Yuvraj2412/SKYFORCE/Final_Hackathon_PPt.docx

Anti-Drone Interceptor

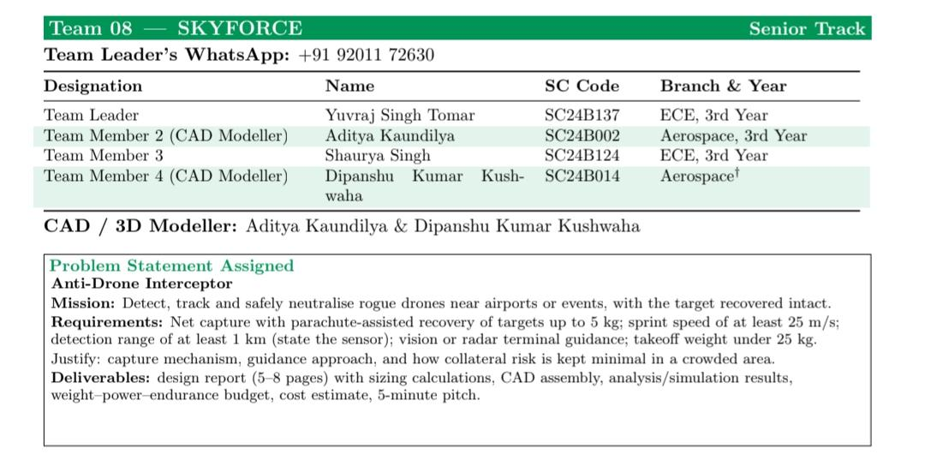
[picture p1: figure]

by Team Skyforce

The brief is to detect, track and safely neutralise a rogue drone near an airport or event, with the target recovered intact. The design must justify the capture mechanism, the guidance approach and how collateral risk is kept minimal. The requirements the design and simulation respect are:

• net capture with parachute-assisted recovery of targets up to 5 kg;

• sprint speed of at least 25 m/s;

• detection range of at least 1 km using a stated sensor (ground radar);

• vision or radar terminal guidance;

• takeoff weight under 25 kg.

Deliverables are the design report with sizing calculations, CAD, analysis/simulation results, a budget and a cost estimate.

Inspiration and Literature Review-:

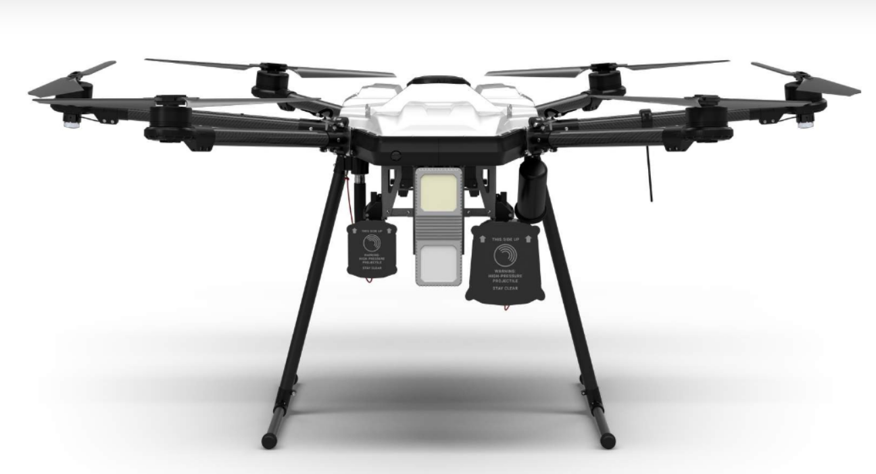
[picture p2: figure]
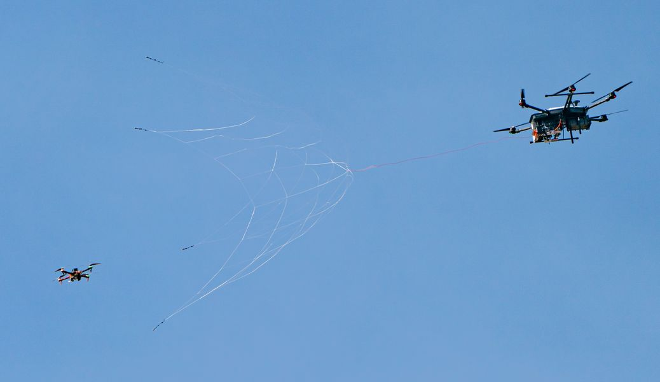
[picture p3: figure]

DroneHunter® F700

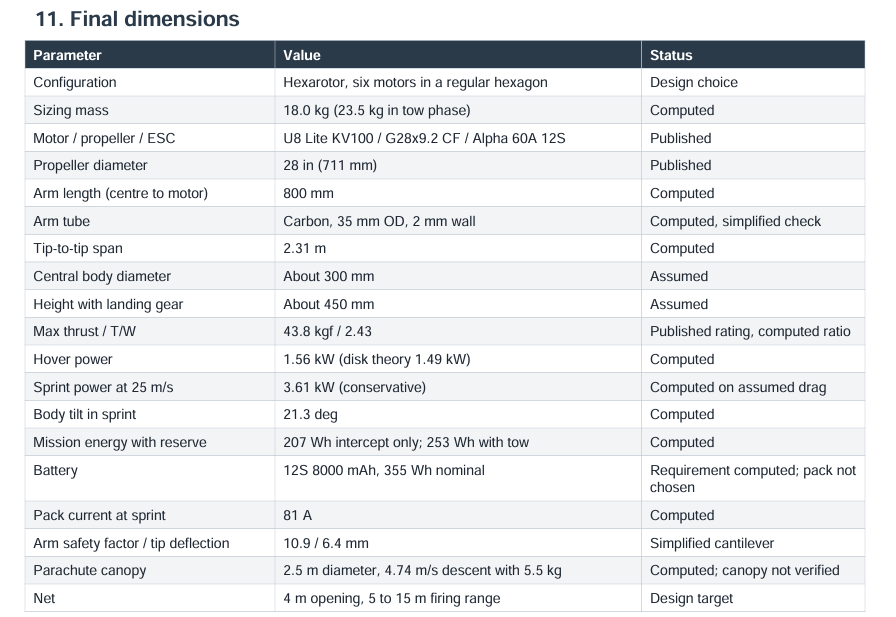
[picture p4: figure]

Used by USA Military for drone interception

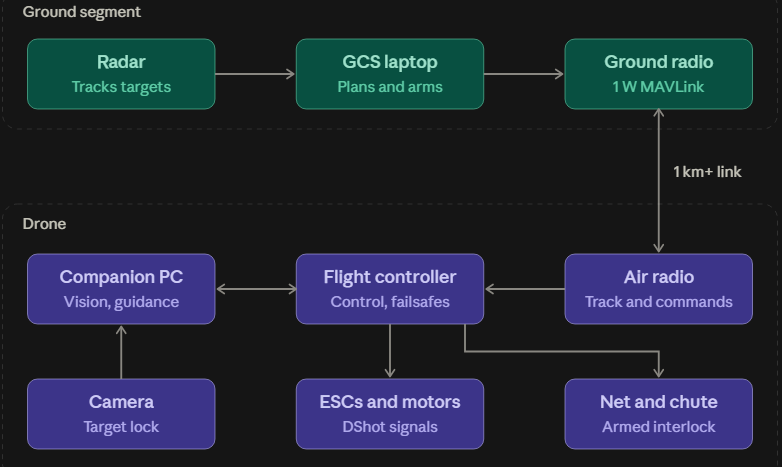
[picture p5: figure]
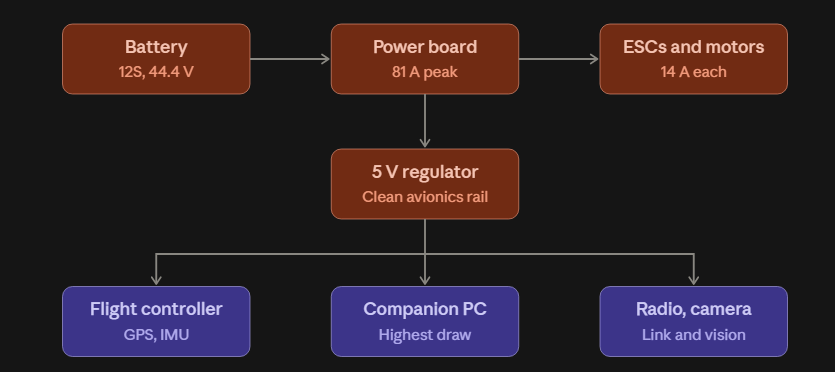
[picture p6: figure]
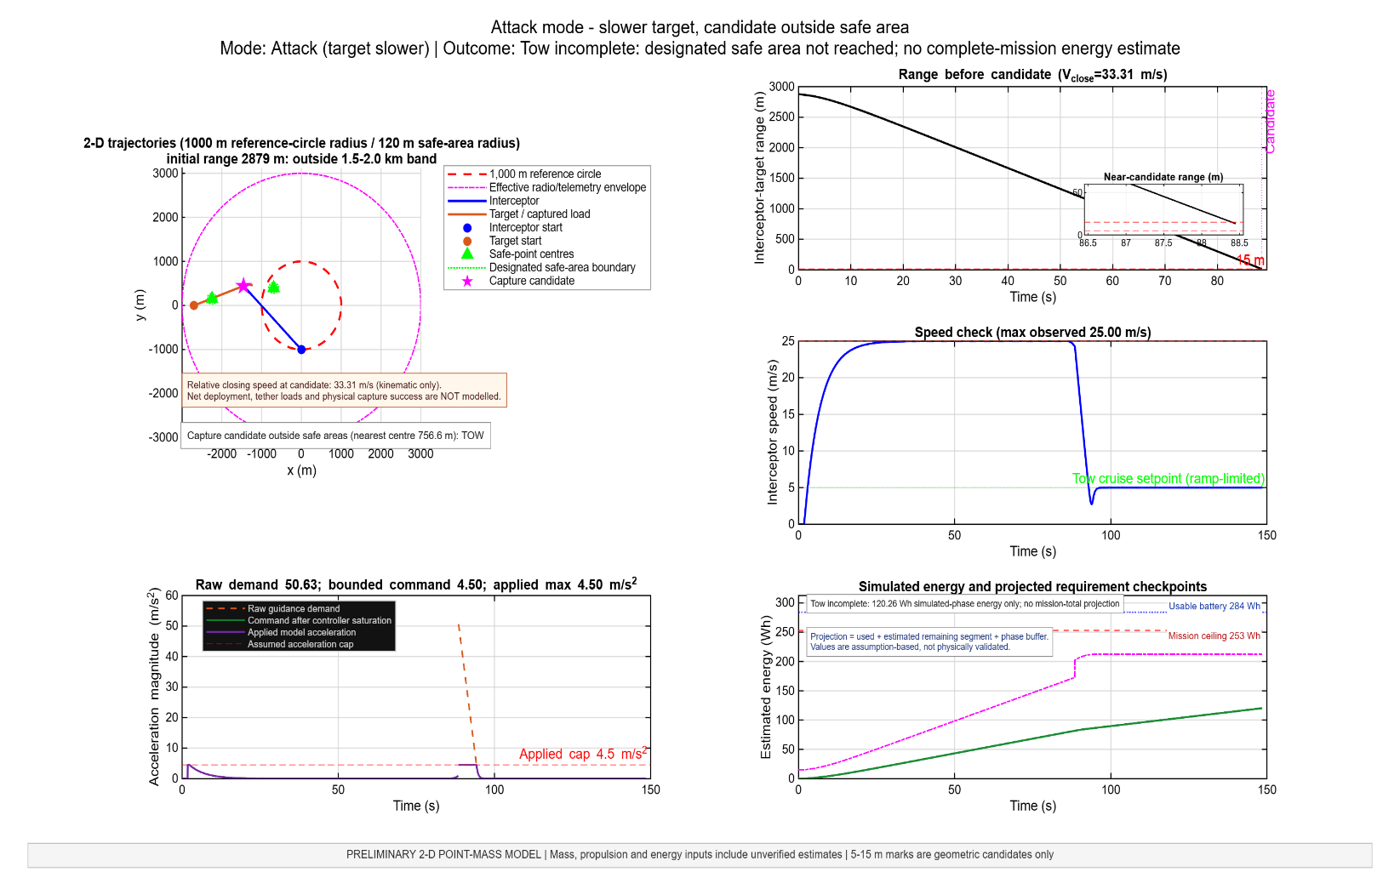
[picture p7: figure]
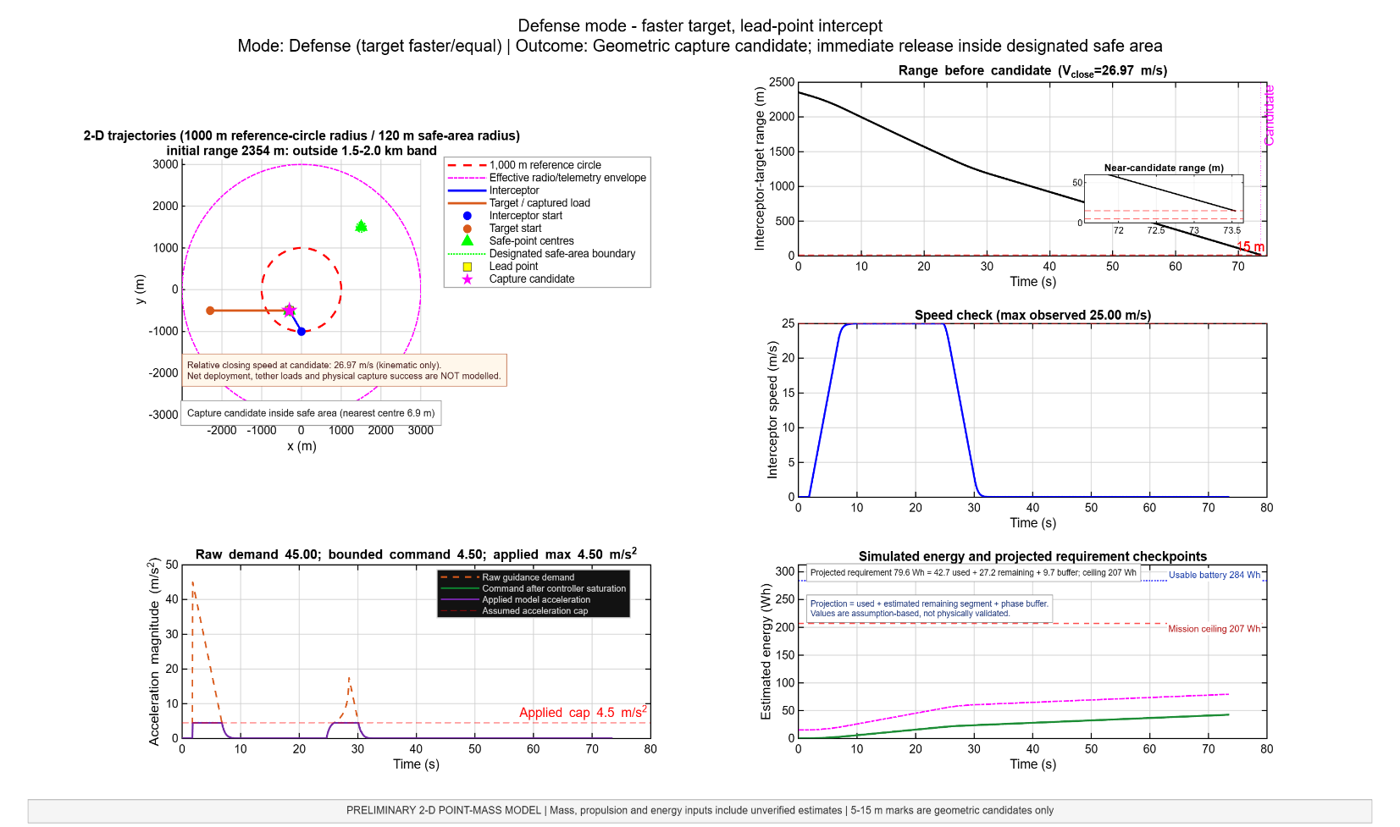
[picture p8: figure]

MATLAB SIMULATIONS-:

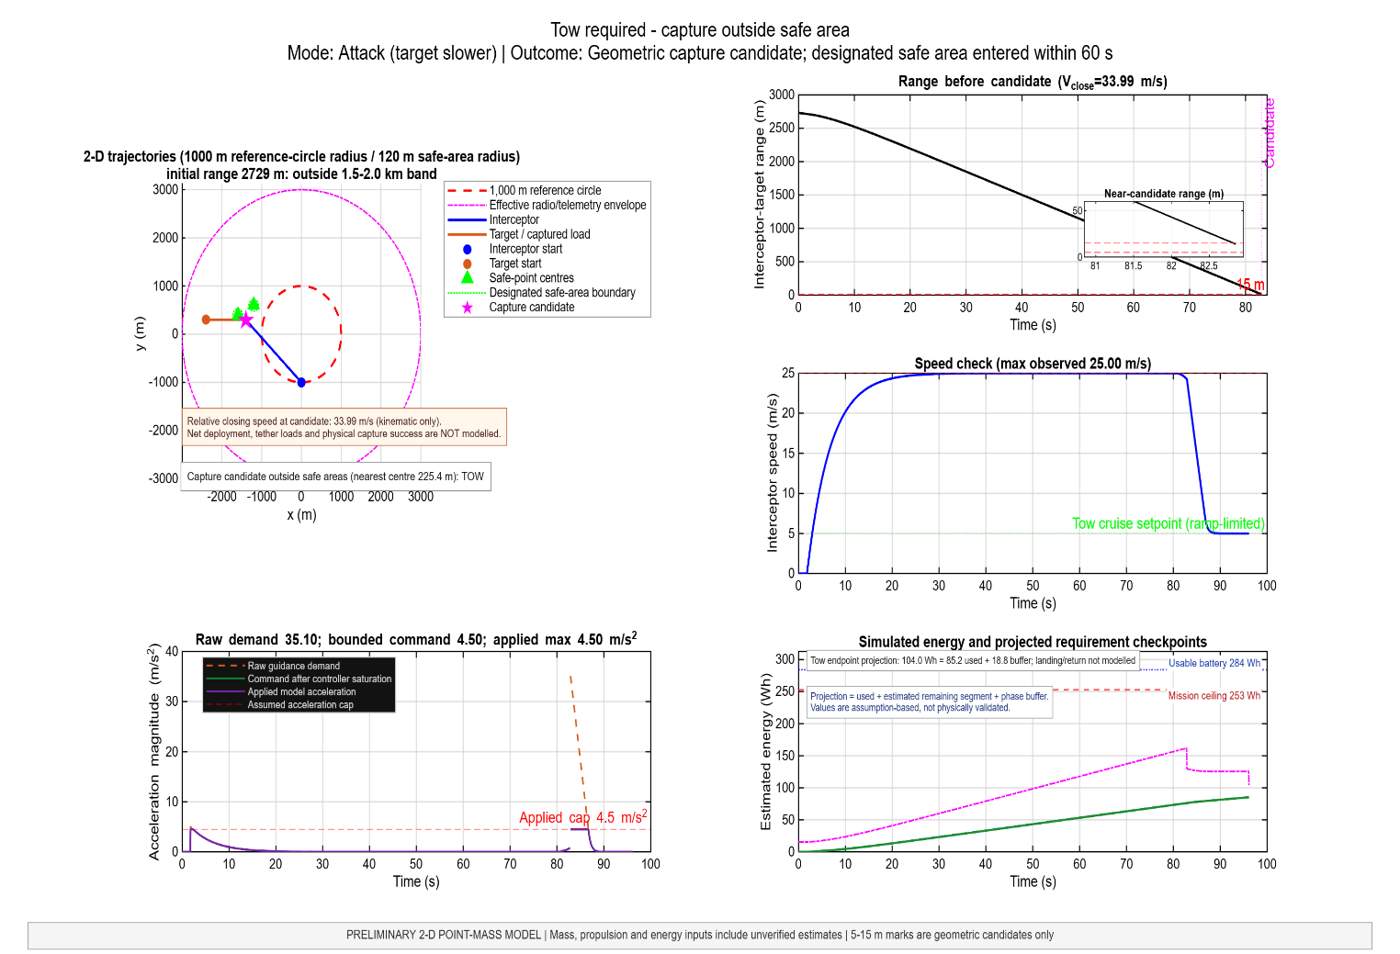
[picture p9: figure]
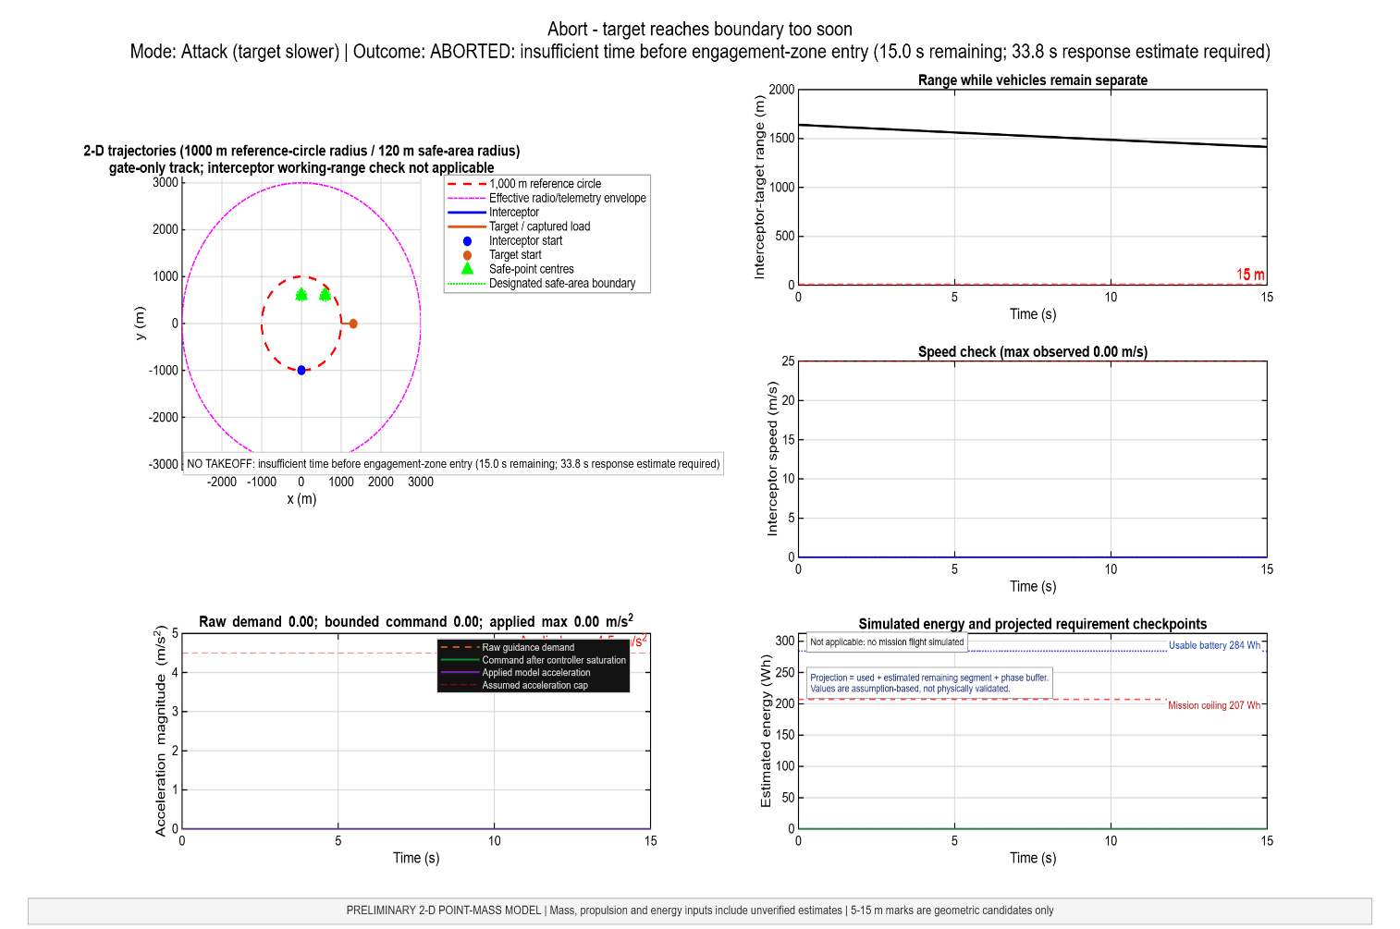
[picture p10: figure]
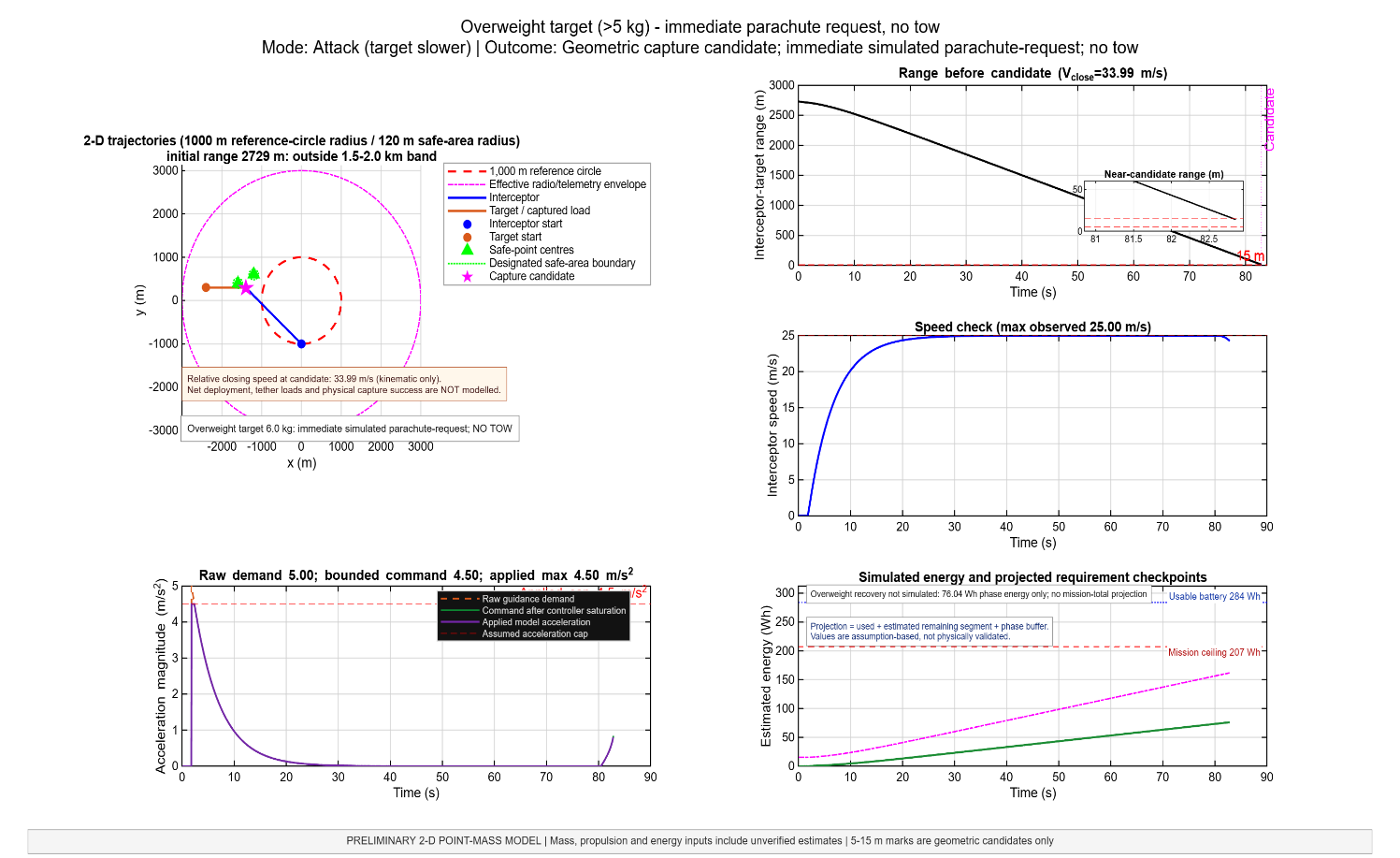
[picture p11: figure]
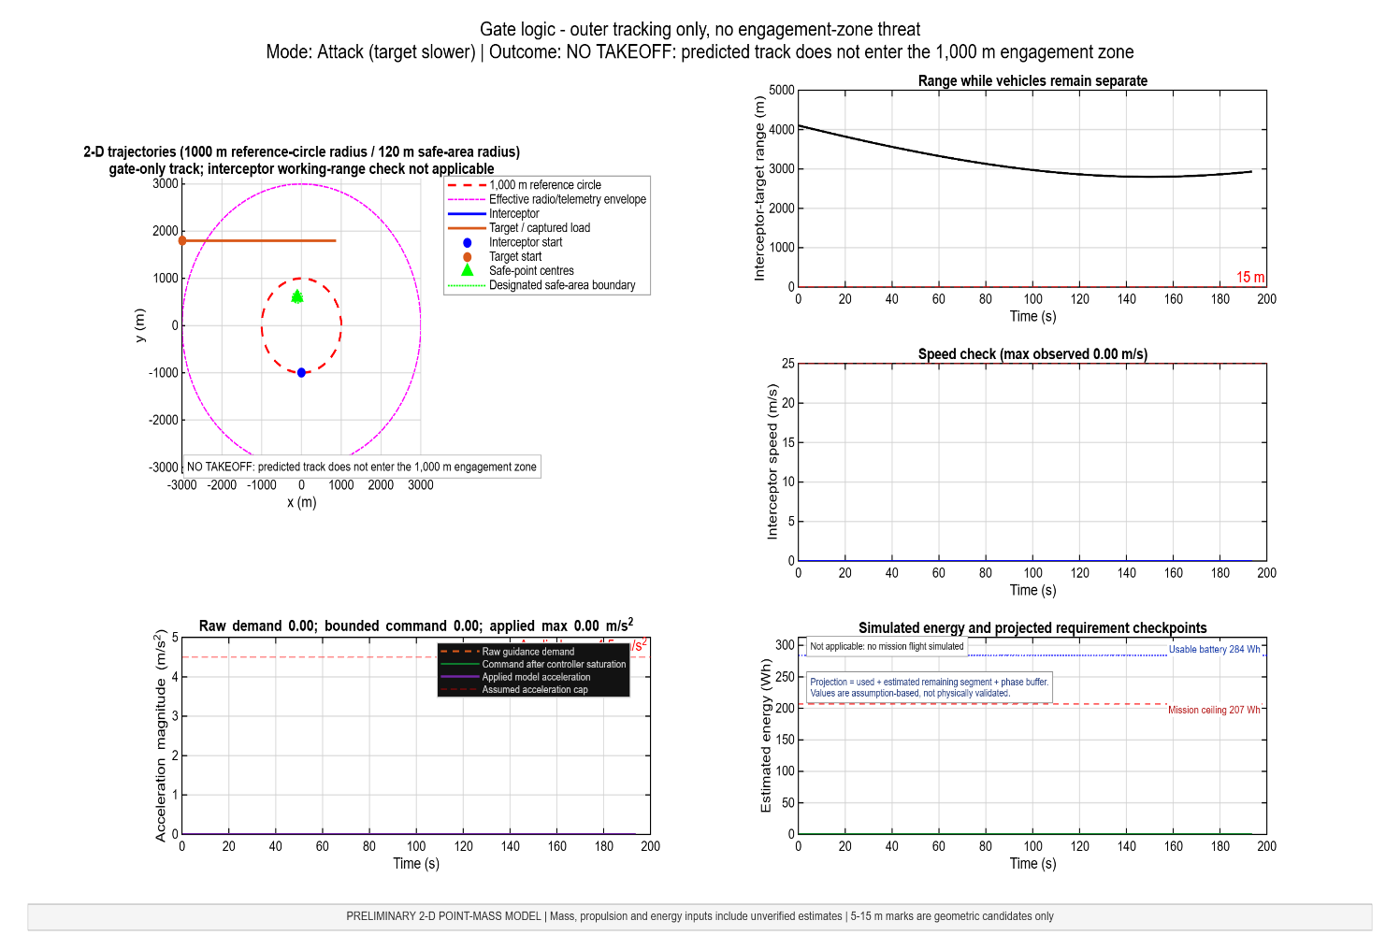
[picture p12: figure]
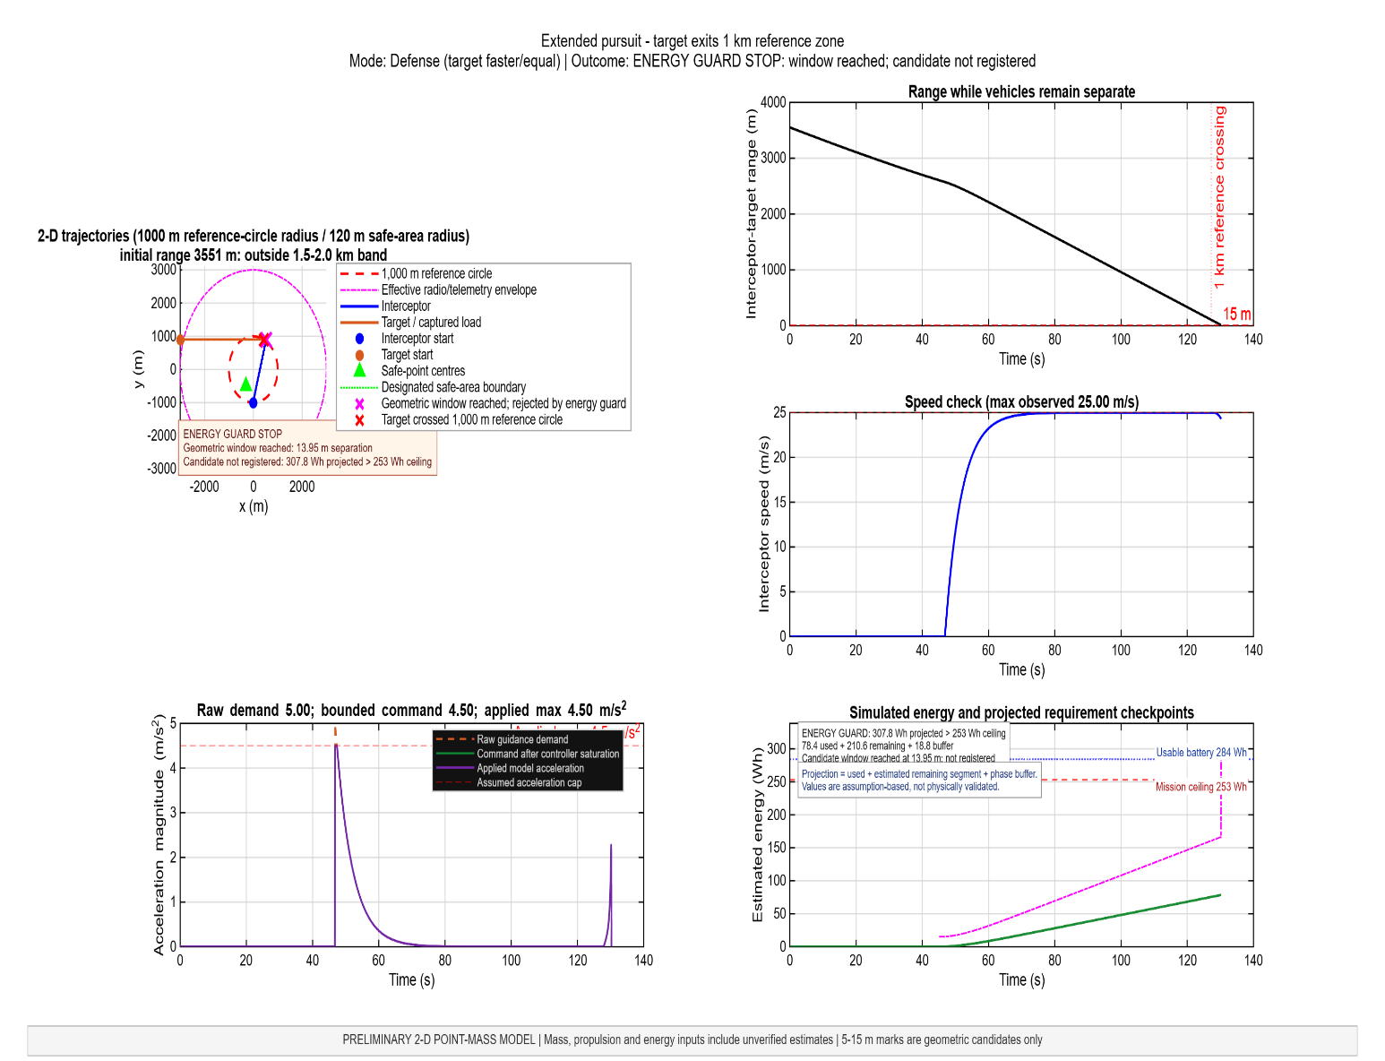
[picture p13: figure]

Limitations or Assumptions-:

1. We are assuming that wind conditions are normal and constant during the whole simulation.
2. We are not accounting for any kind of object collision in the interceptor and target drone path.
3. We are assuming that our radio telematary has a range more than 3km
4. We are not accounting the energy calculations for the drone landing in the simulations right now.
5. The drone is having 18kg of weight in the simulations (it may and will exceed in the real design which we have accounted in the final report)
6. We are assuming a maximum of 4.5 m/s^2 can be supplied by the internal PID control of Interceptor drone’s Fc

CAD Designs-:

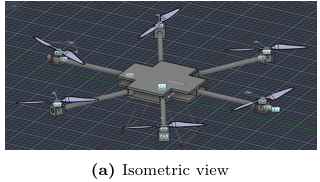
[picture p14: figure]
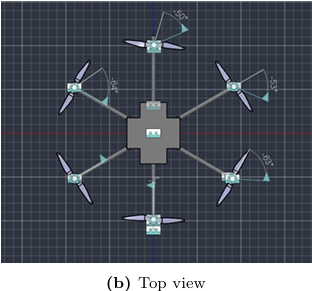
[picture p15: figure]
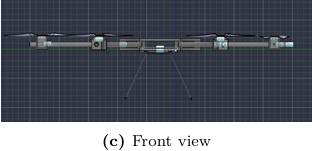
[picture p16: figure]
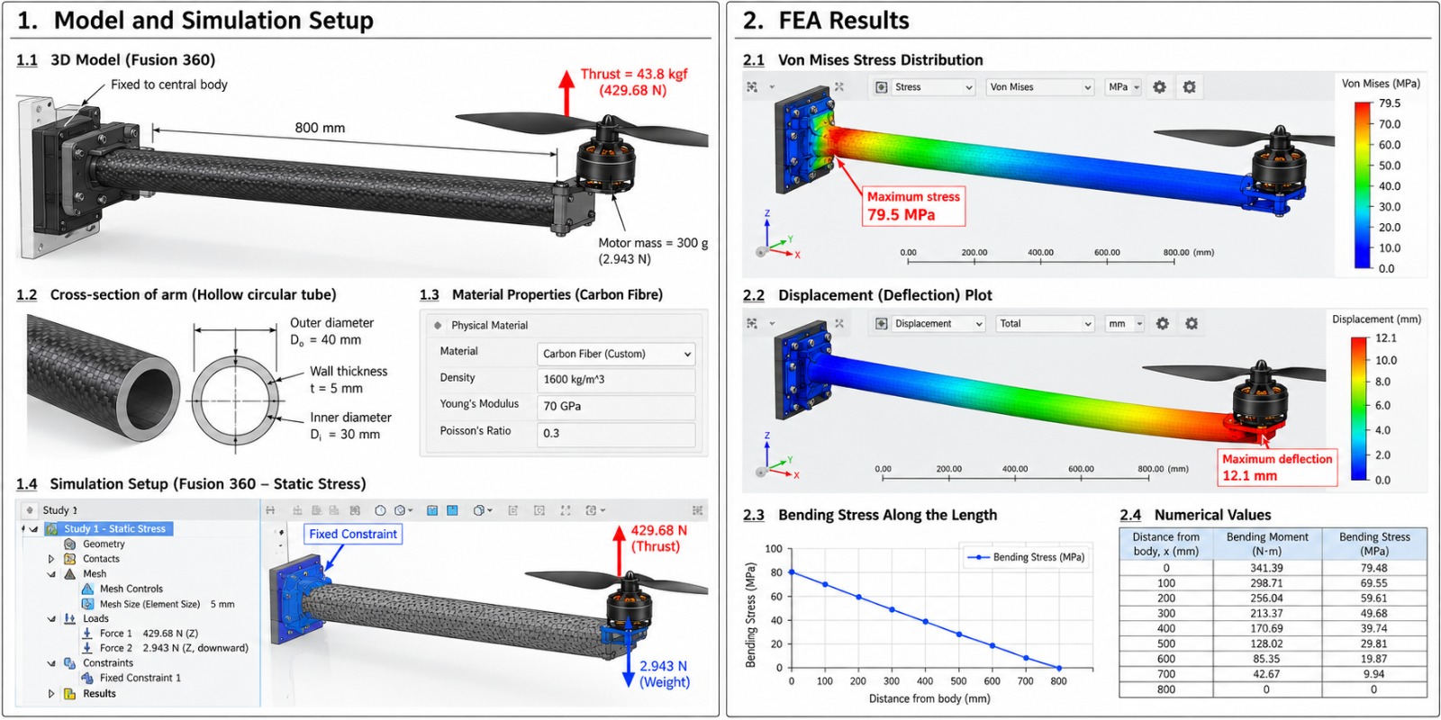
[picture p17: figure]

Overall limitations and Future Scope-:

1. Right now we are not accounting the actual environment drag and wind conditions cause of which all the calculations will be changed in the future
2. We are not discussing the parachute and net mechanism in detail right now, it is treated mostly as a black box
3. We haven’t accounted the cases for miss target, from mentor suggestions we are advised to use a second drone
4. There is no object detection and collision running in our companion board right now which is a very major limitation.
5. We have not done any structural vibrational analysis right now so it may happen that our drone can dismantle in mid air when it reaches the maximum speed of 25 m/s cause of resonant frequency.
6. This model is only limited to capturing Multirortors, right now it does not account for Fixed-plane and VTOL models.

Future Scope-:

1. Using the actual calculations for simulation (modelling the whole environment and drone more rigorously)
2. Using the more accurate CAD models with proper stress and bending analysis on each and every part
3. We can increase the number of interceptor drones or number of nets & parachutes in a drone
4. We can use the AI based models to predict the path of upcoming target drone for better success and capture rate.

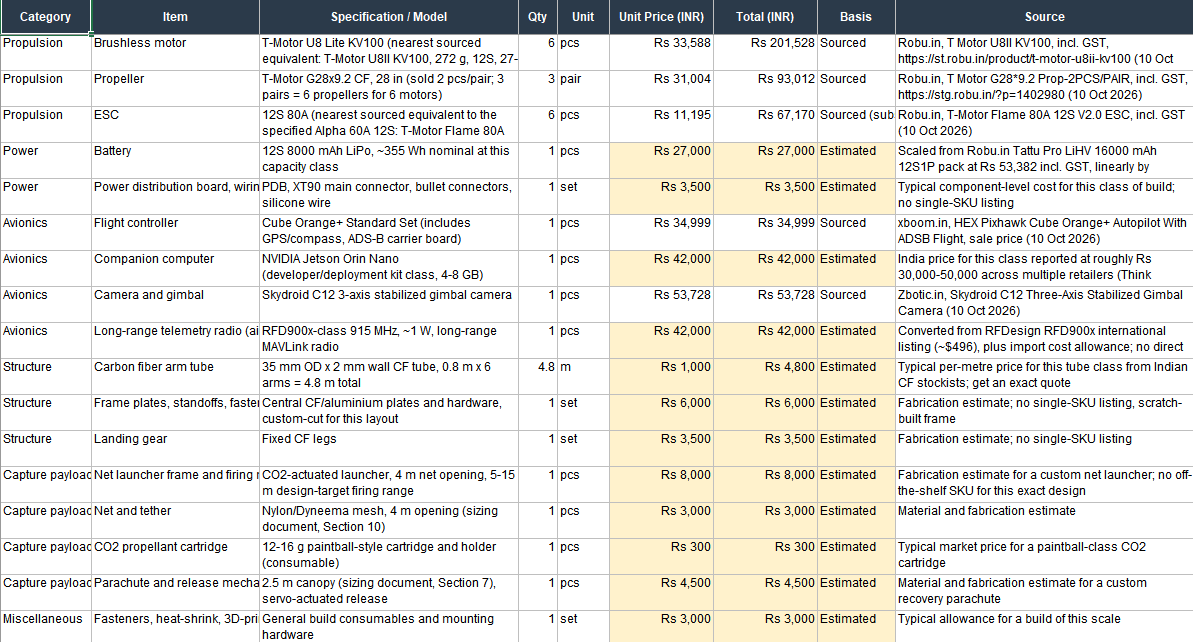
[picture p18: figure]

THANKYOU

Open to Q&A
