Yuvraj2412/SKYFORCE/SIMULATIONS PART/skyforce_figure_08_SKYFORCE_terminal_approach_details.png

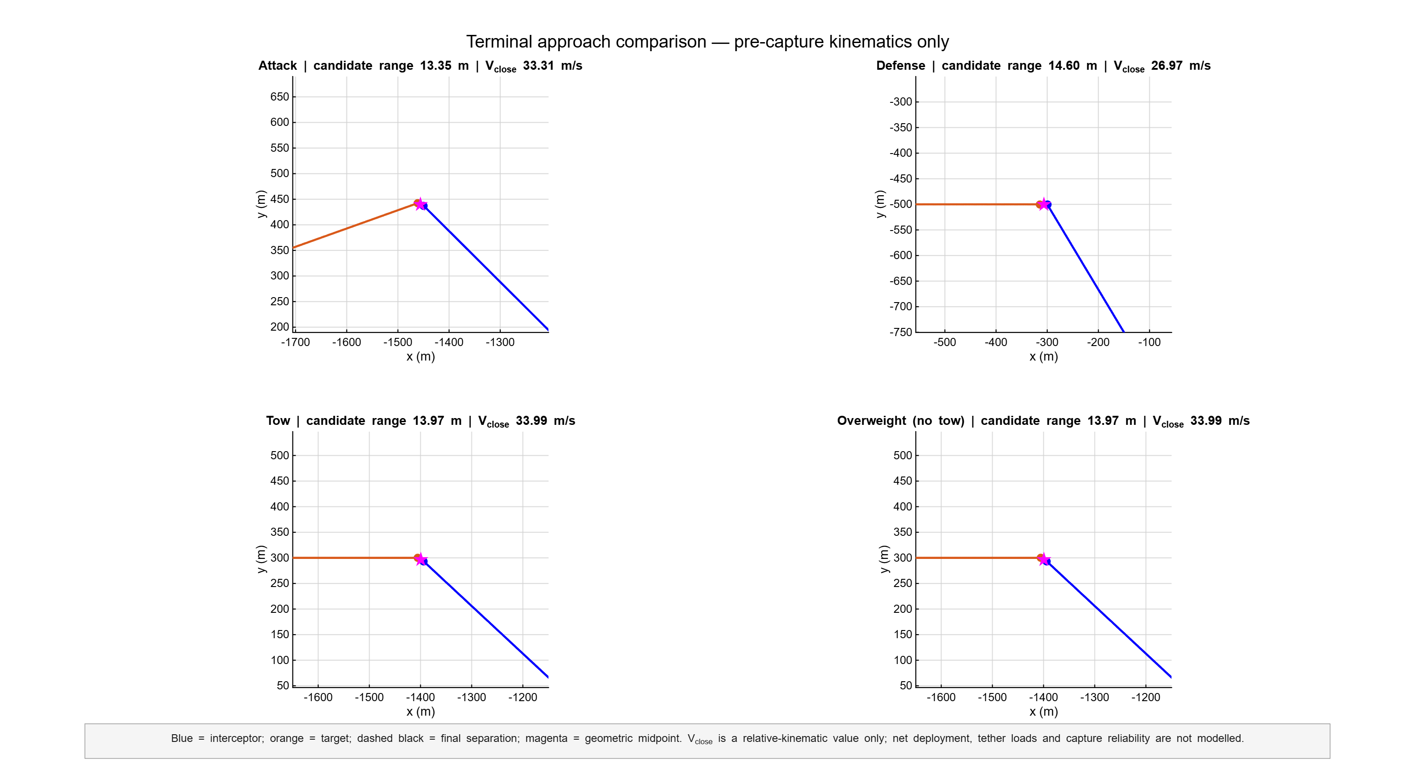
SIMULATIONS PART/skyforce_figure_08_SKYFORCE_terminal_approach_details.png
