Yuvraj2412/SKYFORCE/SIMULATIONS PART/skyforce_figure_09_SKYFORCE_PN_correction_diagnostic.png

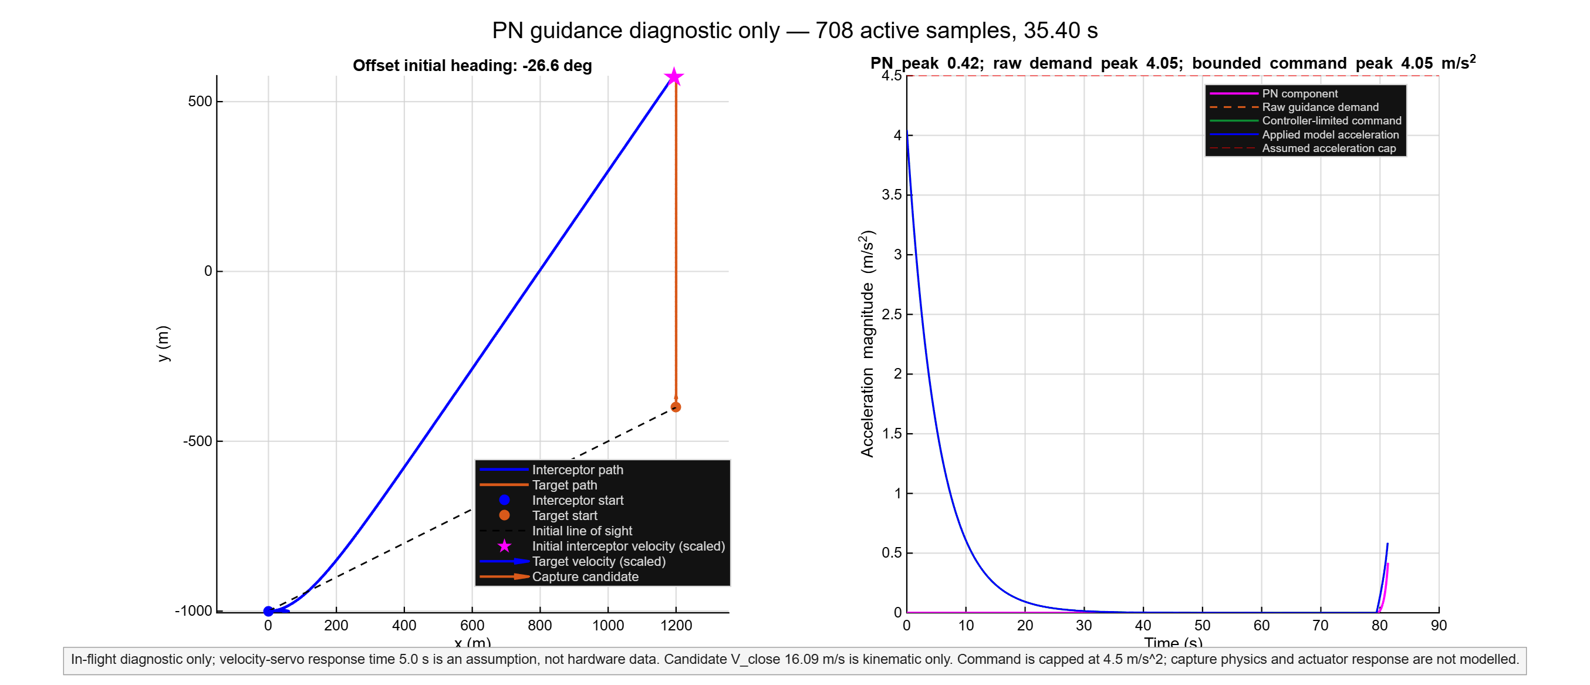
SIMULATIONS PART/skyforce_figure_09_SKYFORCE_PN_correction_diagnostic.png
