Yuvraj2412/SKYFORCE/SIMULATIONS PART/skyforce_figure_11_SKYFORCE_target_mass_limit_recovery_contingency.png

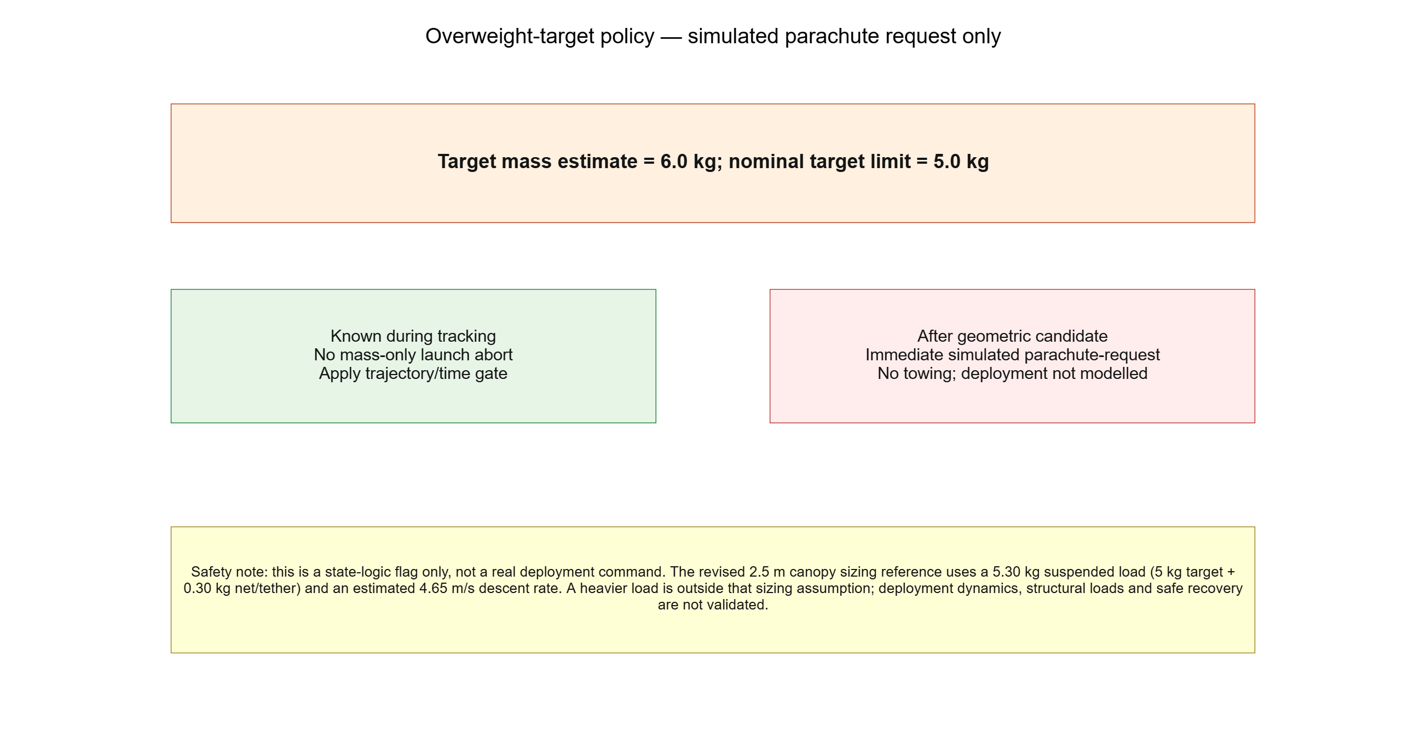
SIMULATIONS PART/skyforce_figure_11_SKYFORCE_target_mass_limit_recovery_contingency.png
