Yuvraj2412/SKYFORCE/SKYFORCE_Bill_of_Equipment.xlsx

Category | Item | Specification / Model | Qty | Unit | Unit Price (INR) | Total (INR) | Basis | Source
Propulsion | Brushless motor | T-Motor U8 Lite KV100 (nearest sourced equivalent: T-Motor U8II KV100, 272 g, 12S, 27-28 in prop) | 6 | pcs | Rs 33588 | Rs 201528 | Sourced | Robu.in, T Motor U8II KV100, incl. GST, https://st.robu.in/product/t-motor-u8ii-kv100 (10 Oct 2026)
Propulsion | Propeller | T-Motor G28x9.2 CF, 28 in (sold 2 pcs/pair; 3 pairs = 6 propellers for 6 motors) | 3 | pair | Rs 31004 | Rs 93012 | Sourced | Robu.in, T Motor G28*9.2 Prop-2PCS/PAIR, incl. GST, https://stg.robu.in/?p=1402980 (10 Oct 2026)
Propulsion | ESC | 12S 80A (nearest sourced equivalent to the specified Alpha 60A 12S: T-Motor Flame 80A 12S V2.0) | 6 | pcs | Rs 11195 | Rs 67170 | Sourced (substitute part) | Robu.in, T-Motor Flame 80A 12S V2.0 ESC, incl. GST (10 Oct 2026)
Power | Battery | 12S 8000 mAh LiPo, ~355 Wh nominal at this capacity class | 1 | pcs | Rs 27000 | Rs 27000 | Estimated | Scaled from Robu.in Tattu Pro LiHV 16000 mAh 12S1P pack at Rs 53,382 incl. GST, linearly by capacity (16Ah to 8Ah); get an exact quote for the 8 Ah size
Power | Power distribution board, wiring, connectors | PDB, XT90 main connector, bullet connectors, silicone wire | 1 | set | Rs 3500 | Rs 3500 | Estimated | Typical component-level cost for this class of build; no single-SKU listing
Avionics | Flight controller | Cube Orange+ Standard Set (includes GPS/compass, ADS-B carrier board) | 1 | pcs | Rs 34999 | Rs 34999 | Sourced | xboom.in, HEX Pixhawk Cube Orange+ Autopilot With ADSB Flight, sale price (10 Oct 2026)
Avionics | Companion computer | NVIDIA Jetson Orin Nano (developer/deployment kit class, 4-8 GB) | 1 | pcs | Rs 42000 | Rs 42000 | Estimated | India price for this class reported at roughly Rs 30,000-50,000 across multiple retailers (Think Robotics, Zbotic); no single confirmed listing
Avionics | Camera and gimbal | Skydroid C12 3-axis stabilized gimbal camera | 1 | pcs | Rs 53728 | Rs 53728 | Sourced | Zbotic.in, Skydroid C12 Three-Axis Stabilized Gimbal Camera (10 Oct 2026)
Avionics | Long-range telemetry radio (air side) | RFD900x-class 915 MHz, ~1 W, long-range MAVLink radio | 1 | pcs | Rs 42000 | Rs 42000 | Estimated | Converted from RFDesign RFD900x international listing (~$496), plus import cost allowance; no direct India retail price found
Structure | Carbon fiber arm tube | 35 mm OD x 2 mm wall CF tube, 0.8 m x 6 arms = 4.8 m total | 4.8 | m | Rs 1000 | Rs 4800 | Estimated | Typical per-metre price for this tube class from Indian CF stockists; get an exact quote
Structure | Frame plates, standoffs, fasteners | Central CF/aluminium plates and hardware, custom-cut for this layout | 1 | set | Rs 6000 | Rs 6000 | Estimated | Fabrication estimate; no single-SKU listing, scratch-built frame
Structure | Landing gear | Fixed CF legs | 1 | set | Rs 3500 | Rs 3500 | Estimated | Fabrication estimate; no single-SKU listing
Capture payload | Net launcher frame and firing mechanism | CO2-actuated launcher, 4 m net opening, 5-15 m design-target firing range | 1 | pcs | Rs 8000 | Rs 8000 | Estimated | Fabrication estimate for a custom net launcher; no off-the-shelf SKU for this exact design
Capture payload | Net and tether | Nylon/Dyneema mesh, 4 m opening (sizing document, Section 10) | 1 | pcs | Rs 3000 | Rs 3000 | Estimated | Material and fabrication estimate
Capture payload | CO2 propellant cartridge | 12-16 g paintball-style cartridge and holder (consumable) | 1 | pcs | Rs 300 | Rs 300 | Estimated | Typical market price for a paintball-class CO2 cartridge
Capture payload | Parachute and release mechanism | 2.5 m canopy (sizing document, Section 7), servo-actuated release | 1 | pcs | Rs 4500 | Rs 4500 | Estimated | Material and fabrication estimate for a custom recovery parachute
Miscellaneous | Fasteners, heat-shrink, 3D-printed mounts, foam | General build consumables and mounting hardware | 1 | set | Rs 3000 | Rs 3000 | Estimated | Typical allowance for a build of this scale
TOTAL (one drone, no spares) |  |  |  |  |  | Rs 598037
Notes
- Currency: INR. Quantities are for one drone only (no spares or contingency), per the user's instructions.
- Yellow-shaded rows (Unit Price, Total, Basis columns) are estimates, not a specific vendor listing — get a real quote before purchase.
- White rows are sourced from a specific Indian retailer listing, checked via web search on 10 Oct 2026; prices may have changed since and should be re-verified before ordering.
- The ESC and companion computer rows use the nearest sourced equivalent to the exact part named in the sizing document (Alpha 60A 12S, Jetson Orin Nano variant); confirm the exact variant before purchase.
- This BOM excludes the ground segment (ground radar, GCS laptop, ground radio) and ground-control software, per the request to bill the drone itself.
- No manual RC safety-pilot override is included — the drone relies solely on the long-range ground-radio link (team decision, 10 Oct 2026). The independent RC backup link suggested in the architecture document was considered and intentionally dropped.
- This BOM excludes shipping, customs/import duty on items not already marked GST-inclusive, and any competition entry or venue costs.
