Yuvraj2412/SKYFORCE/CAD PART/Full_assembly.step

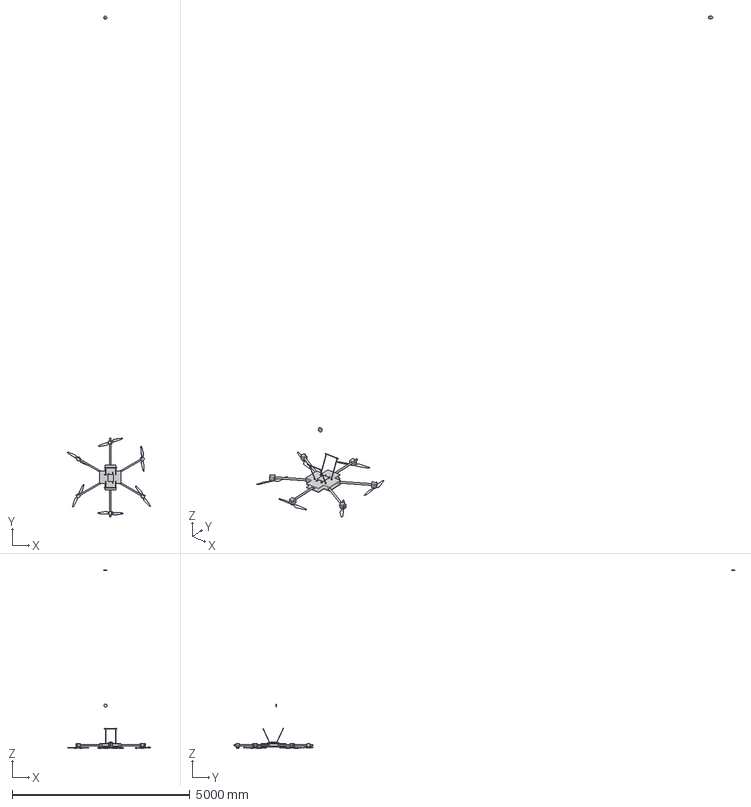
[picture p35: CAD file, 2026-10-11]
CAD PART/Full_assembly.step
2331.1 x 14078.3 x 5040.0 mm
P28-外发桨叶 x 6
