Yuvraj2412/SKYFORCE/CAD PART/propel.step

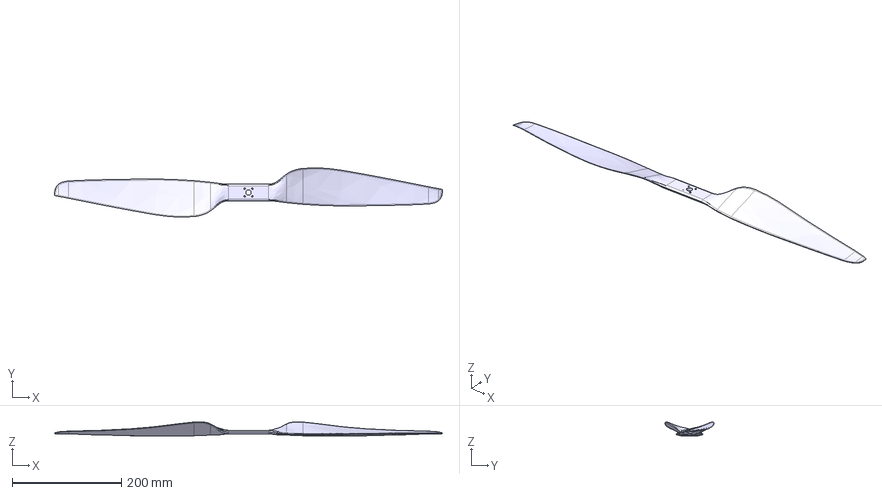
[picture p36: CAD file, 2026-10-11]
CAD PART/propel.step
711.2 x 90.4 x 26.6 mm
