Yuvraj2412/SKYFORCE/CAD PART/base_landing.step

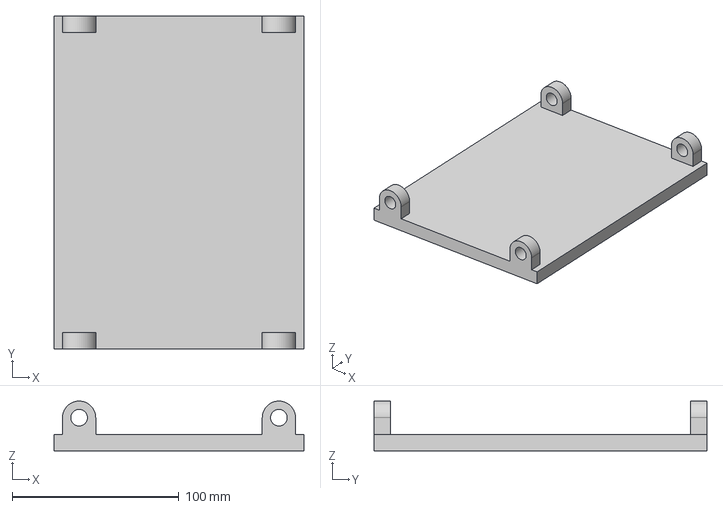
[picture p37: CAD file, 2026-10-11]
CAD PART/base_landing.step
150.0 x 200.0 x 30.0 mm
