Yuvraj2412/SKYFORCE/CAD PART/Motor holder.step

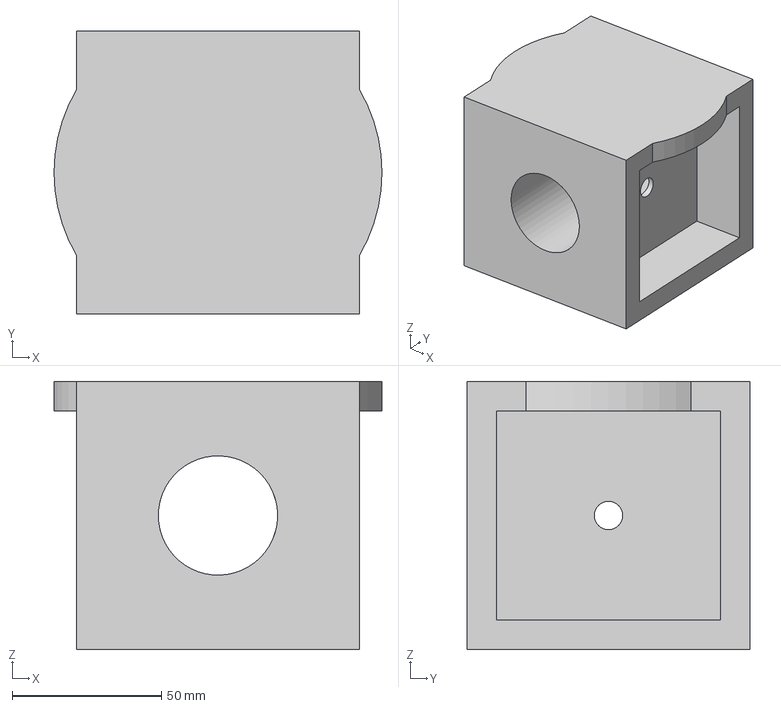
[picture p38: CAD file, 2026-10-11]
CAD PART/Motor holder.step
110.0 x 95.0 x 90.0 mm
