Yuvraj2412/SKYFORCE/CAD PART/frame.step

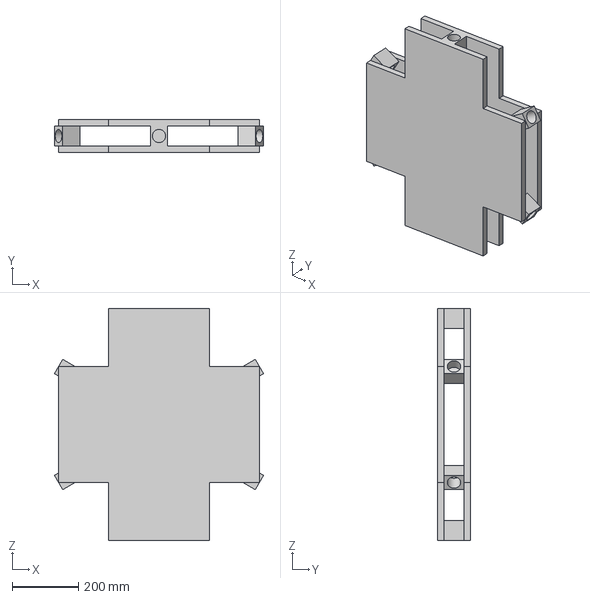
[picture p39: CAD file, 2026-10-11]
CAD PART/frame.step
631.2 x 100.0 x 700.0 mm
