Yuvraj2412/SKYFORCE/CAD PART/Landing Gear.step

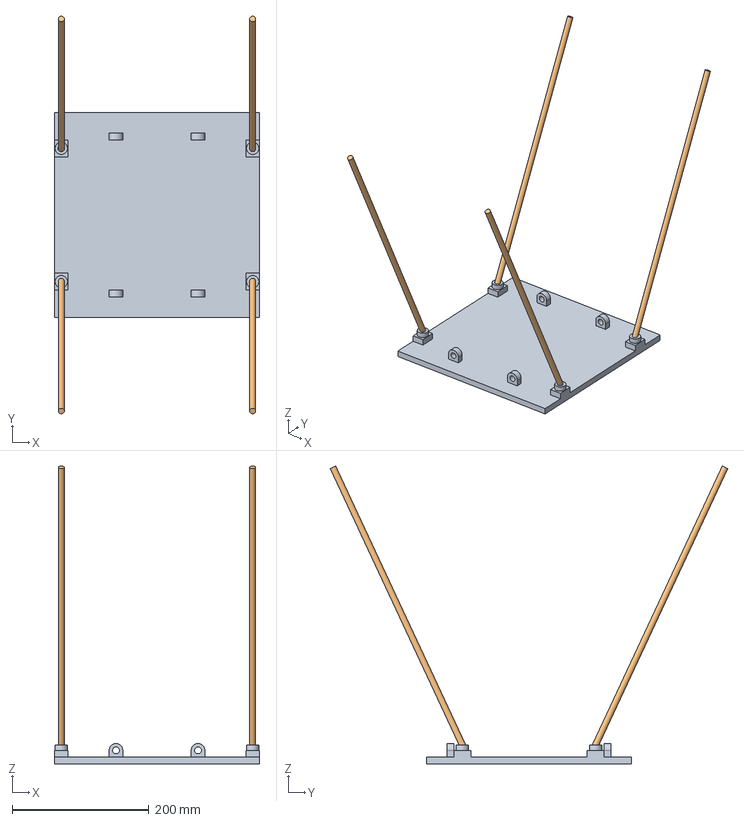
[picture p40: CAD file, 2026-10-11]
CAD PART/Landing Gear.step
300.0 x 581.8 x 436.0 mm
