Yuvraj2412/SKYFORCE/CAD PART/pushing_rod.step

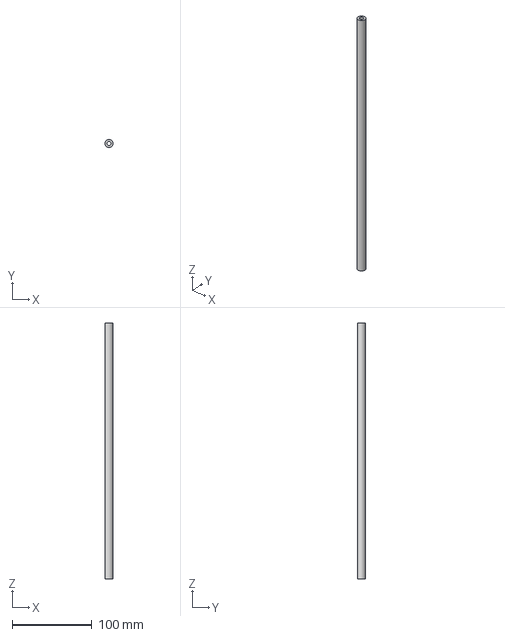
[picture p41: CAD file, 2026-10-11]
CAD PART/pushing_rod.step
9.99 x 10.00 x 320.0 mm
