Yuvraj2412/SKYFORCE/CAD PART/motor mount.step

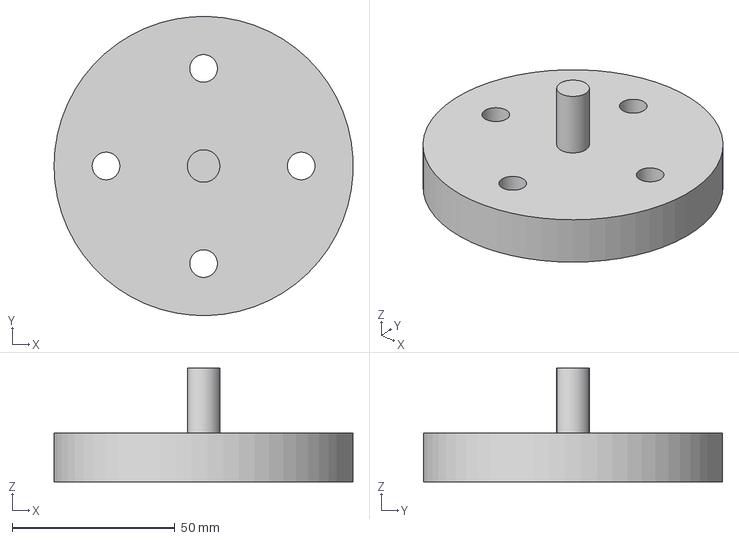
[picture p42: CAD file, 2026-10-11]
CAD PART/motor mount.step
91.9 x 92.0 x 35.0 mm
