Yuvraj2412/SKYFORCE/CAD PART/Connector.step

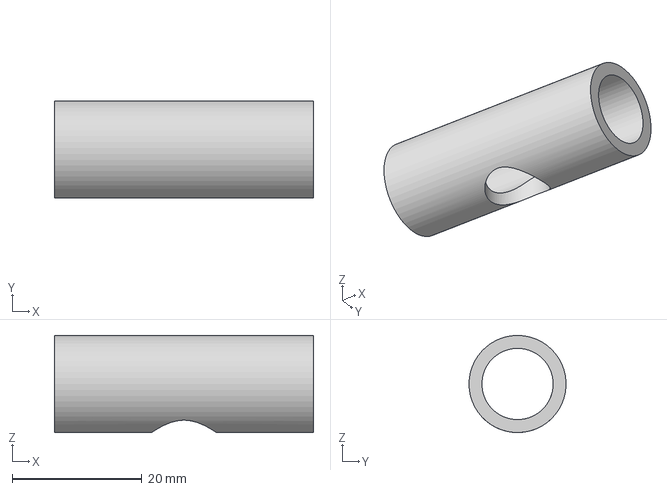
[picture p43: CAD file, 2026-10-11]
CAD PART/Connector.step
40.0 x 15.0 x 15.0 mm
