Yuvraj2412/SKYFORCE/(list of files, cad)

Other CAD files:
CAD PART/Top assembly.f3d
